Metisek/PROME/Electronics/Components.pdf

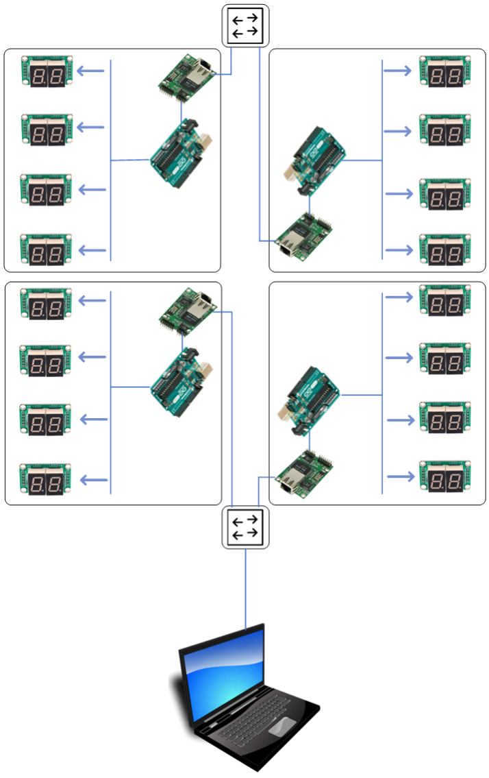
[picture p7: figure]

Main elements:

1. MOXA NE4110S – Ethernet -> COM server
2. Arduino UNO – Mikrocontroler
3. WHMXE-595-2 – 7x2 display module
4. PS-05-5 – 230-5V transformer
5. GAINTA G17081UBK – 1U rack case

# Concept and elements

poniedziałek, 23 maja 2022 19:08

V 3.0 Strona 1

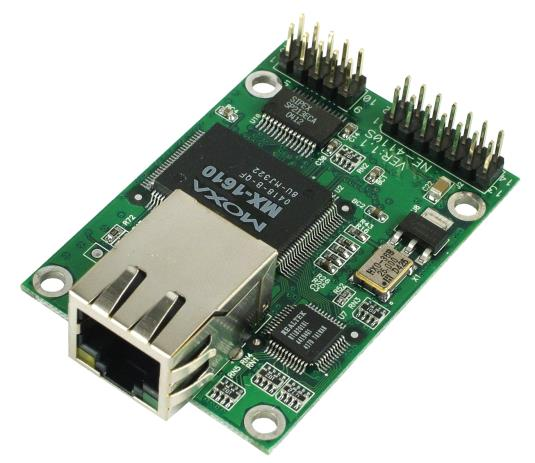
[picture p8: figure]

MOXA NE-4100 Series (https://www.moxa.com/en/products/industrial-edge-connectivity/serial-device-servers/serial-embedded-modules/ne-4100-series)

Documentation:
User manual: https://cdn-cms.azureedge.net/getmedia/655cb5db-0c27-4eb8-96a3-04efb5cc5544/moxa-ne-4100-seriesmanual-v11.0.pdf (https://cdn-cms.azureedge.net/getmedia/655cb5db-0c27-4eb8-96a3-04efb5cc5544/moxa-ne-4100-series-manual-v11.0.pdf)

1.

SDK programmer guide: https://cdn-cms.azureedge.net/getmedia/edbc294db4b8-4696-9677-4fbf6241075f/moxa-ne-4100-series-programming-guide-manual-v5.0.pdf (https://cdn-cms.azureedge.net/getmedia/edbc294d-b4b8-4696-9677-4fbf6241075f/moxa-ne-4100-series-programming-guide-manual-v5.0.pdf)

2.

Datasheet: https://cdn-cms.azureedge.net/getmedia/90d20bdc-668b-44dd-97edb26c91d37502/moxa-ne-4100-series-datasheet-v1.3.pdf (https://cdn-cms.azureedge.net/getmedia/90d20bdc-668b-44dd-97ed-b26c91d37502/moxa-ne-4100-series-datasheet-v1.3.pdf)

3.

# MOXA NE4110S

poniedziałek, 23 maja 2022 19:28

# WHMXE-595-2

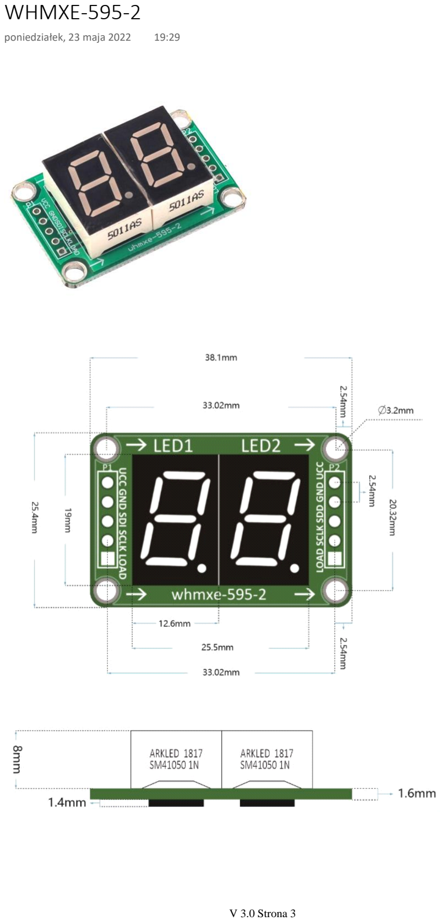
[picture p9: page 3]

poniedziałek, 23 maja 2022 19:29

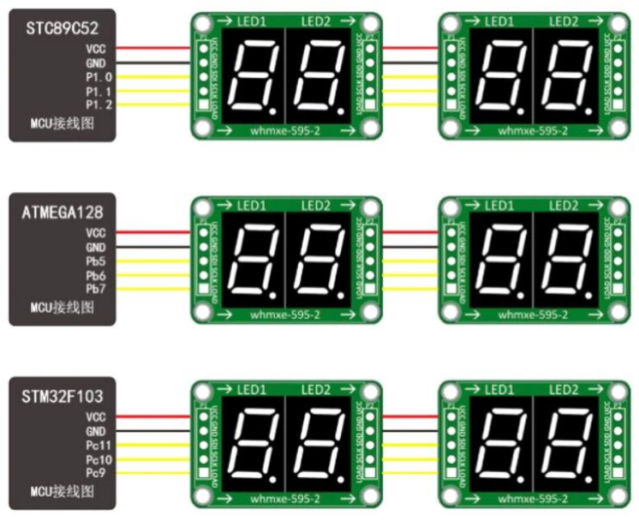
[picture p10: figure]

Similar module is described here:
Arduino and 2-Digit Seven Segment Module - Ardumotive Arduino Greek Playground (https://www.ardumotive.com/2-digit-7seg-display-en.html)

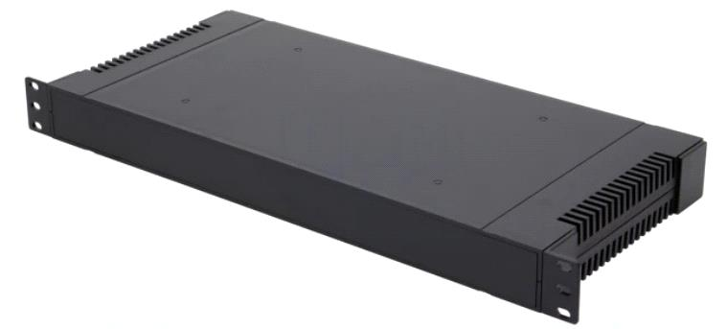
[picture p11: figure]

# G17081UBK GAINTA

Z <https://www.tme.eu/pl/details/g17081ubk/obudowy-system-19-cali/gainta/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> (https://www.tme.eu/pl/details/g17081ubk/obudowy-system-19-cali/gainta/?brutto=1&currency=PLN)

# GAINTA G17081UBK

sobota, 23 października 2021 19:35

PS-05-5

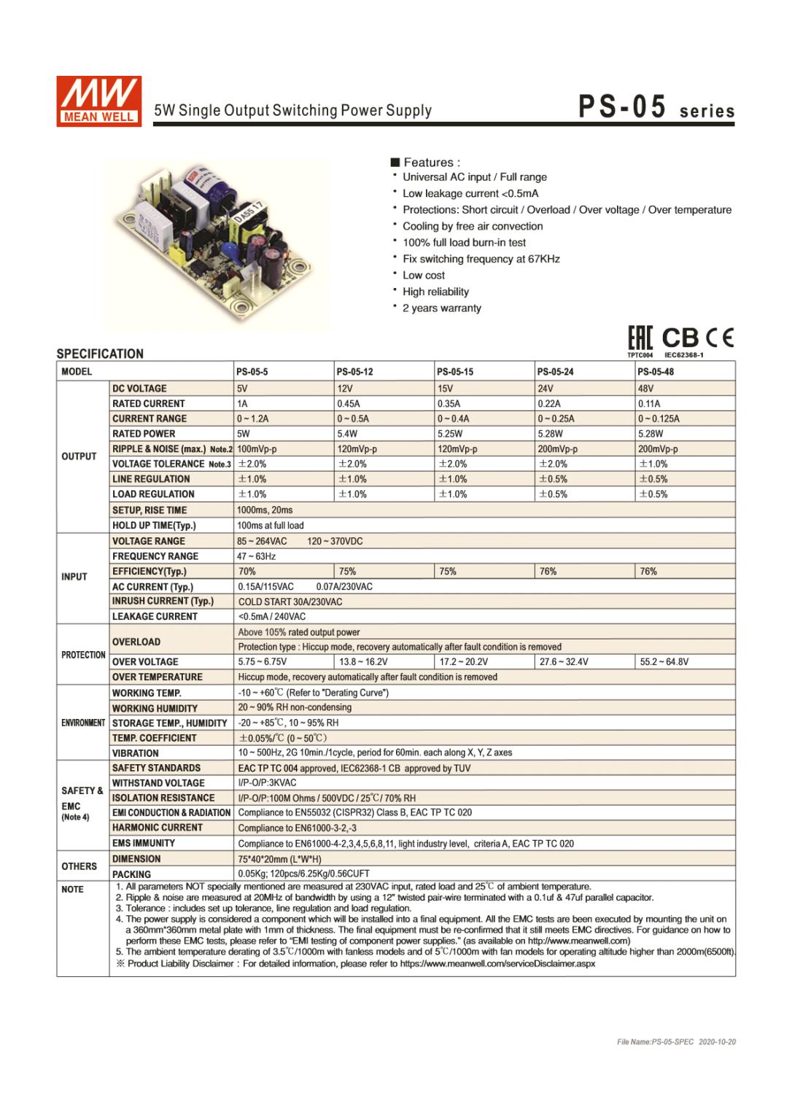
[picture p12: page 6]

poniedziałek, 30 maja 2022 11:55

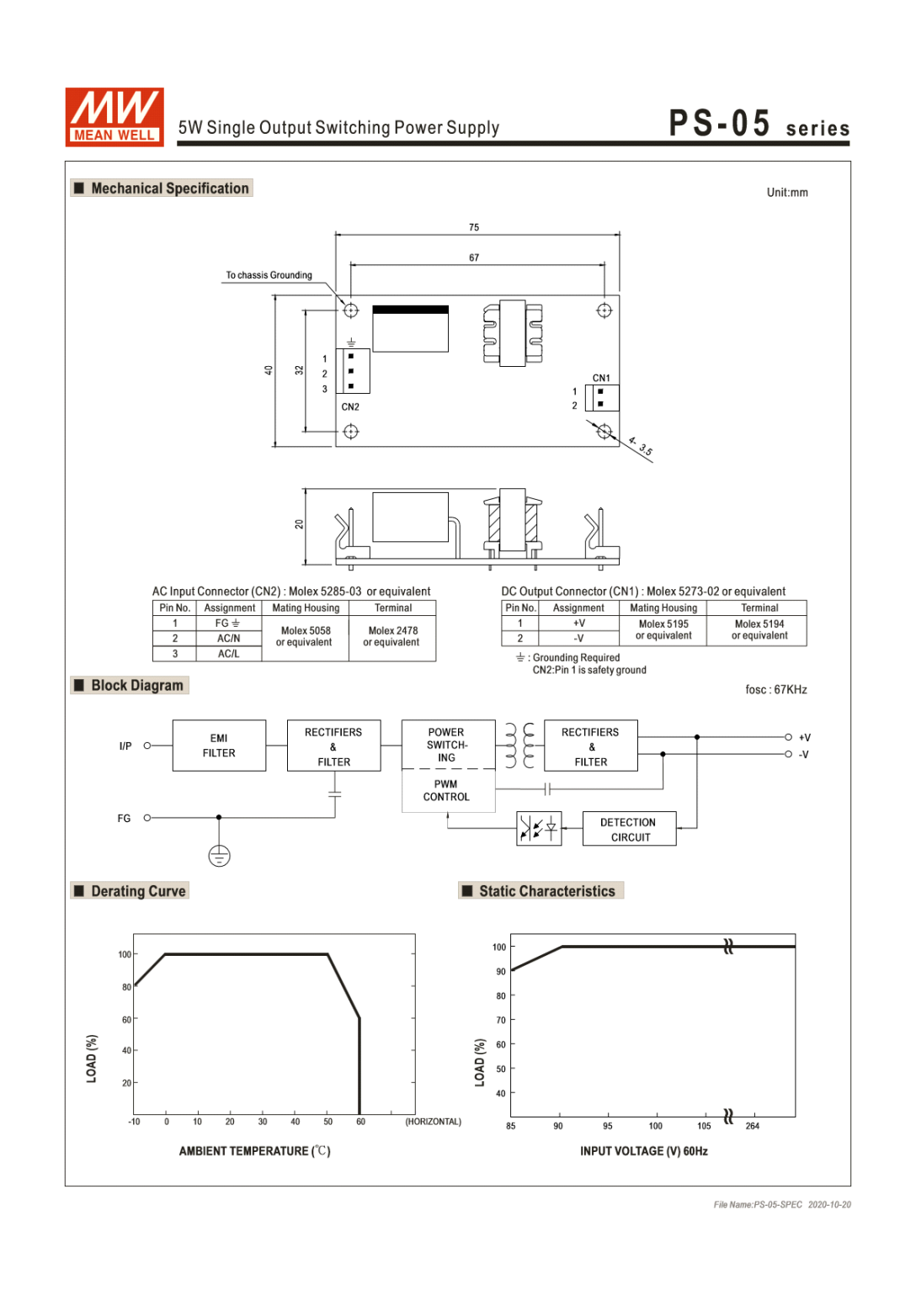
[picture p13: page 7]
