Metisek/PROME/Code/config.ini

[main]
prome_count = 4

[database]
path = baza_testowa.db
table = Uczniowie
filters = [['Klasa', '1T'], ['Grupa', 1]]
draw = Dziennik

[P1]
port = COM21
baudrate = 115200
bytesize = 8
displays = 4
stopbits = 1
parity = None

[P2]
port = COM22
baudrate = 115200
bytesize = 8
displays = 4
stopbits = 1
parity = None

[P3]
port = COM23
baudrate = 115200
bytesize = 8
displays = 4
stopbits = 1
parity = None

[P4]
port = COM24
baudrate = 115200
bytesize = 8
displays = 4
stopbits = 1
parity = None

[P5]
port = COM4
baudrate = 115200
bytesize = 8
displays = 4
stopbits = 1
parity = None

[P6]
port = 
baudrate = 115200
bytesize = 8
displays = 7
stopbits = 1
parity = None

[P7]
port = COM5
baudrate = 115200
bytesize = 8
displays = 4
stopbits = 1
parity = None

[P8]
port = 
baudrate = 115200
bytesize = 8
displays = 4
stopbits = 1
parity = None

[P9]
port = 
baudrate = 115200
bytesize = 8
displays = 4
stopbits = 1
parity = None

[P10]
port = 
baudrate = 115200
bytesize = 8
displays = 4
stopbits = 1
parity = None

[P11]
port = 
baudrate = 115200
bytesize = 8
displays = 4
stopbits = 1
parity = None

[P12]
port = 
baudrate = 115200
bytesize = 8
displays = 4
stopbits = 1
parity = None

[P13]
port = 
baudrate = 115200
bytesize = 8
displays = 4
stopbits = 1
parity = None

[P14]
port = 
baudrate = 115200
bytesize = 8
displays = 4
stopbits = 1
parity = None

[P15]
port = 
baudrate = 115200
bytesize = 8
displays = 4
stopbits = 1
parity = None

[P16]
port = 
baudrate = 115200
bytesize = 8
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
displays = 4
stopbits = 1
parity = None

[P97]
port = 
baudrate = 115200
bytesize = 8
displays = 4
stopbits = 1
parity = None

[P98]
port = 
baudrate = 115200
bytesize = 8
displays = 4
stopbits = 1
parity = None

[P99]
port = 
baudrate = 115200
bytesize = 8
displays = 4
stopbits = 1
parity = None
