Metisek/PROME/(commit log)

2022-06-17 ARduino code
2022-08-28 Arduino code update
2022-08-28 Created assembly info and components list
2022-09-25 Printing CWD in terminal for debug purposes
